avollmaier/ReShuffled/KiCad/Version 0.8/SVGs & PNGs/Atmega324P-Diplomarbeit-Perl.png

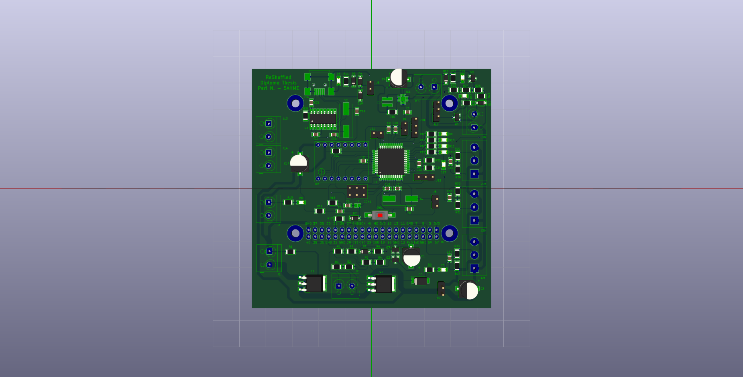
KiCad/Version 0.8/SVGs & PNGs/Atmega324P-Diplomarbeit-Perl.png
