avollmaier/ReShuffled/README.md

<hr>
<hr>
<h1 id="protokoll-nr.-03--">Diplomarbeit  </h1> 
<table> 
<thead> 
<tr>
<th>Diplomant</th>
<th>Aufgabenbereich</th>
<th>Betreuer</th>
</tr>
</thead>
<tbody>
<tr>
<td>Vollmaier Alois</td>
<td>Software</td>
<td><a href="https://github.com/ManfredSteiner">Manfred Steiner</a></td>
</tr>
<tr>
<td>Perl Nicolas</td>
<td>Elektronik</td>
<td><a href="https://github.com/ManfredSteiner">Manfred Steiner</a></td>
</tr>
<tr>
<td>Hörmann Stefan</td>
<td>Mechanik</td>
<td>Gerhard Pretterhofer</td>
</tr>
</tbody>
</table><hr>
<h3 id="themen-übersicht">Themen-Übersicht</h3>
<ul>
<li><strong>[1]</strong> - Konzept
<ul>
<li>[1.1] -</li>
</ul>
</li>
<li><strong>[2]</strong>  - <em>Meilensteinplanung</em>
<ul>
<li>[2.1] -</li>
</ul>
</li>
<li><strong>[3]</strong>  - Links und Sonstiges</li>
</ul>
<hr>
