avollmaier/ReShuffled/Blockdiagramms/Hardware V1.png

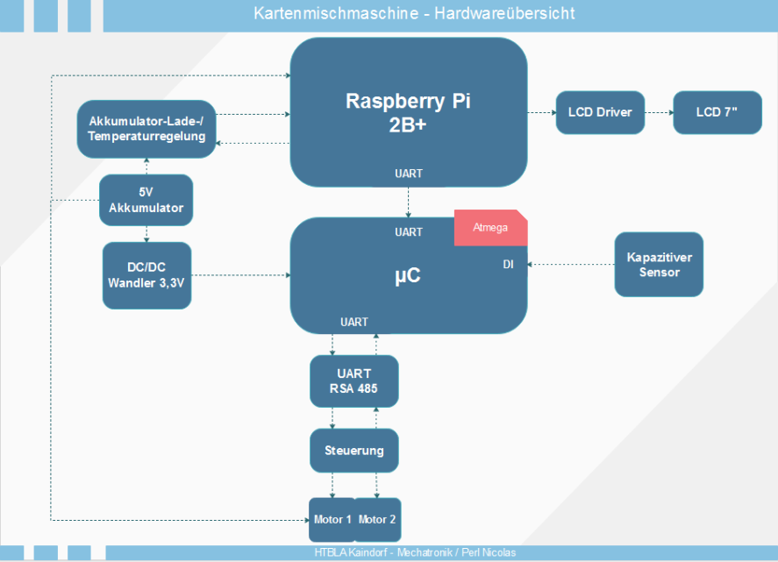
Blockdiagramms/Hardware V1.png
