avollmaier/ReShuffled/(list of files, drawings)

Other design files:
KiCad/Version 0.8/Backups/Atmega324P-Diplomarbeit-Perl-2-11-2019.dsn
KiCad/Version 0.8/Backups/Atmega324P-Diplomarbeit-Perl-16-12-19.dsn
KiCad/Version 0.8/Backups/Atmega324P-Diplomarbeit-Perl-18-09-2019.dsn
KiCad/Version 0.8/Backups/Atmega324P-Diplomarbeit-Perl-18-11-19.dsn
KiCad/Version 0.8/Backups/Atmega324P-Diplomarbeit-Perl-25-11-19.dsn
KiCad/Version 0.8/Backups/Atmega324P-Diplomarbeit-Perl-25-11-2019.dsn
KiCad/Version 0.8/Backups/Atmega324P-Diplomarbeit-Perl-26-11-19.dsn
KiCad/Version 0.8/Backups/Atmega324P-Diplomarbeit-Perl-26-11-2019.dsn
KiCad/Version 0.8/Backups/Atmega324P-Diplomarbeit-Perl-29-11-19.dsn
KiCad/Version 0.8/Backups/Atmega324P-Diplomarbeit-Perl-300819.dsn
KiCad/Version 0.8/Backups/Atmega324P-Diplomarbeit-Perl-1112019.dsn
KiCad/Version 0.8/Backups/Atmega324P-Diplomarbeit-Perl-11012019.dsn
KiCad/Version 0.8/Backups/Atmega324P-Diplomarbeit-Perl-test.dsn
KiCad/Version 0.8/Backups/test123.dsn
