avollmaier/ReShuffled/KiCad/Version 0.8/Atmega324P-Diplomarbeit-Perl.kicad_pcb

## KiCad design KiCad/Version 0.8/Atmega324P-Diplomarbeit-Perl.kicad_pcb (2020-02-07)

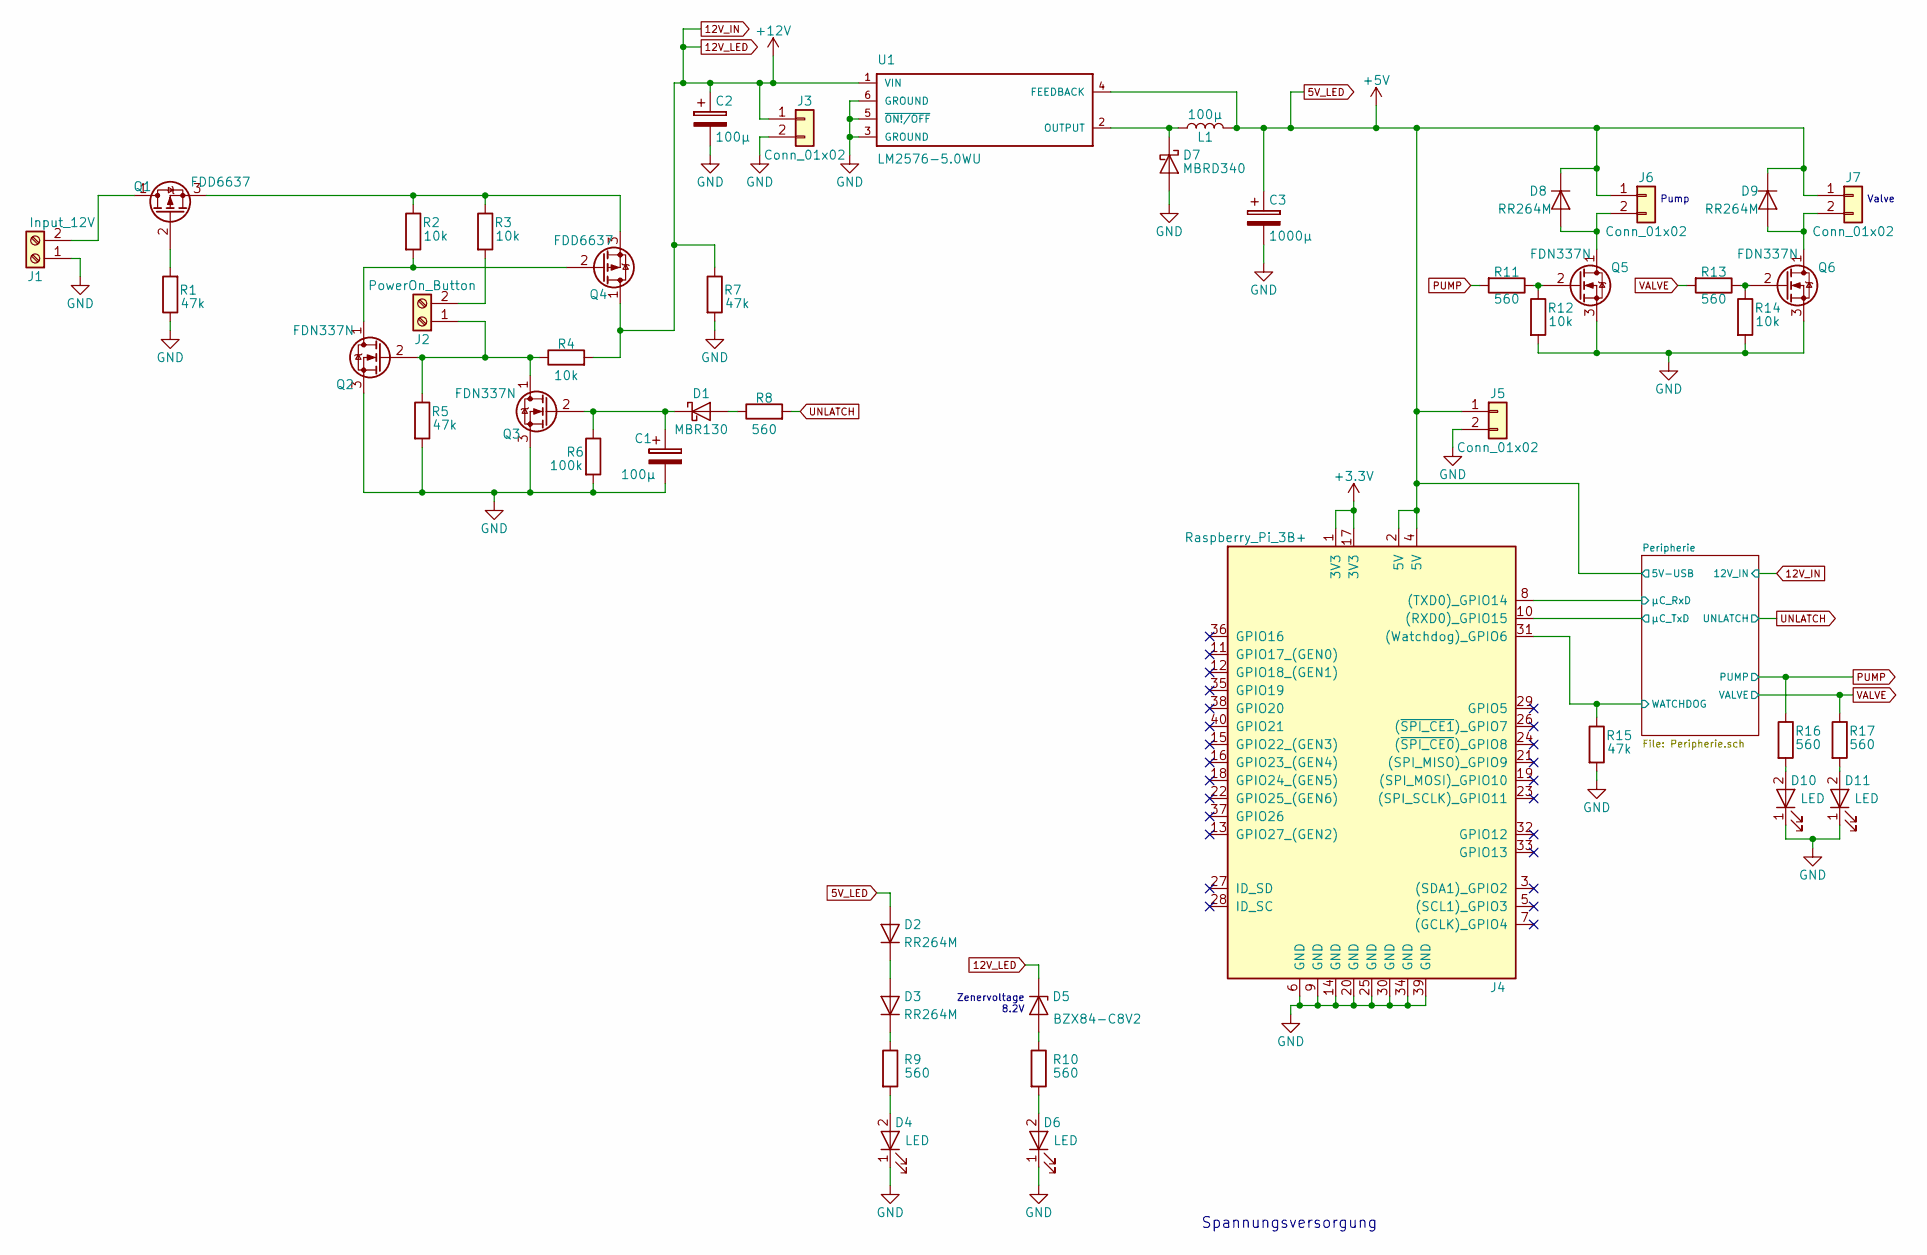
[picture p26: schematic Atmega324P-Diplomarbeit-Perl.sch]

Parts:
C1, C2: 100µ; CP_Elec_8x6.7
C3: 1000µ; CP_Elec_8x10
D1: MBR130; D_SOD-123
D2, D3, D8, D9: RR264M; D_SOD-123
D4, D6, D10, D11: LED; LED_0805
D5: BZX84-C8V2; D_SOT-23_ANK
D7: MBRD340; TO-252-2_Rectifier
J1: Input_12V; Terminalblock-2x-5mm
J2: PowerOn_Button; Terminalblock-2x-5mm
J3, J5, J6, J7: Conn_01x02; Pin_Header_Straight_2x01_Pitch2.54mm
J4: Raspberry_Pi_3B+; Pin_Header_Straight_2x20_Pitch2.54mm
L1: 100µ; L_12x12mm_h6mm
Q1, Q4: FDD6637; TO-252-2_Rectifier
Q2, Q3, Q5, Q6: FDN337N; SOT-23
R1, R5, R7, R15: 47k; R_0805_HandSoldering
R2, R3, R4, R12, R14: 10k; R_0805_HandSoldering
R6: 100k; R_0805_HandSoldering
R8, R9, R10, R11, R13, R16, R17: 560; R_0805_HandSoldering
U1: LM2576-5.0WU; DPAK6P170_1524X459L254X81N

Connections:
5V_LED: C3.1, D2.2 (A), D8.1 (K), D9.1 (K), J4.2 (5V), J4.4 (5V), J5.1, J6.1, J7.1, L1.2, U1.4 (FEEDBACK); also elsewhere on the board
+3V3: J4.1 (3V3), J4.17 (3V3); also elsewhere on the board
/Peripherie/WATCHDOG: J4.31 ((Watchdog)_GPIO6), R15.1; also elsewhere on the board
/Peripherie/µC_RxD: J4.8 ((TXD0)_GPIO14); also elsewhere on the board
/Peripherie/µC_TxD: J4.10 ((RXD0)_GPIO15); also elsewhere on the board
GND: C1.2, C2.2, C3.2, D4.1 (K), D6.1 (K), D7.1 (A), D10.1 (K), D11.1 (K), J1.1, J3.2, J4.6 (GND), J4.9 (GND), J4.14 (GND), J4.20 (GND), J4.25 (GND), J4.30 (GND), J4.34 (GND), J4.39 (GND), J5.2, Q2.3 (S), Q3.3 (S), Q5.3 (S), Q6.3 (S), R1.1, R5.2, R6.2, R7.2, R12.2, R14.2, R15.2, U1.3 (GROUND), U1.5 (~ON!/OFF~), U1.6 (GROUND); also elsewhere on the board
unnamed: C1.1, D1.2 (K), Q3.2 (G), R6.1
unnamed: D1.1 (A), R8.1
unnamed: D2.1 (K), D3.2 (A)
unnamed: D3.1 (K), R9.1
unnamed: D4.2 (A), R9.2
unnamed: D5.2 (A), R10.1
unnamed: D6.2 (A), R10.2
unnamed: D7.2 (K), L1.1, U1.2 (OUTPUT)
unnamed: D8.2 (A), J6.2, Q5.1 (D)
unnamed: D9.2 (A), J7.2, Q6.1 (D)
unnamed: D10.2 (A), R16.2
unnamed: D11.2 (A), R17.2
unnamed: J2.1, Q2.2 (G), Q3.1 (D), R4.1, R5.1
unnamed: J2.2, R3.2
unnamed: Q1.2 (G), R1.2
unnamed: Q5.2 (G), R11.1, R12.1
unnamed: Q6.2 (G), R13.1, R14.1
PUMP: R11.2, R16.1; also elsewhere on the board
UNLATCH: R8.2; also elsewhere on the board
VALVE: R13.2, R17.1; also elsewhere on the board

Notes on the sheet:
Spannungsversorgung
Zenervoltage 8.2V
Pump
Valve

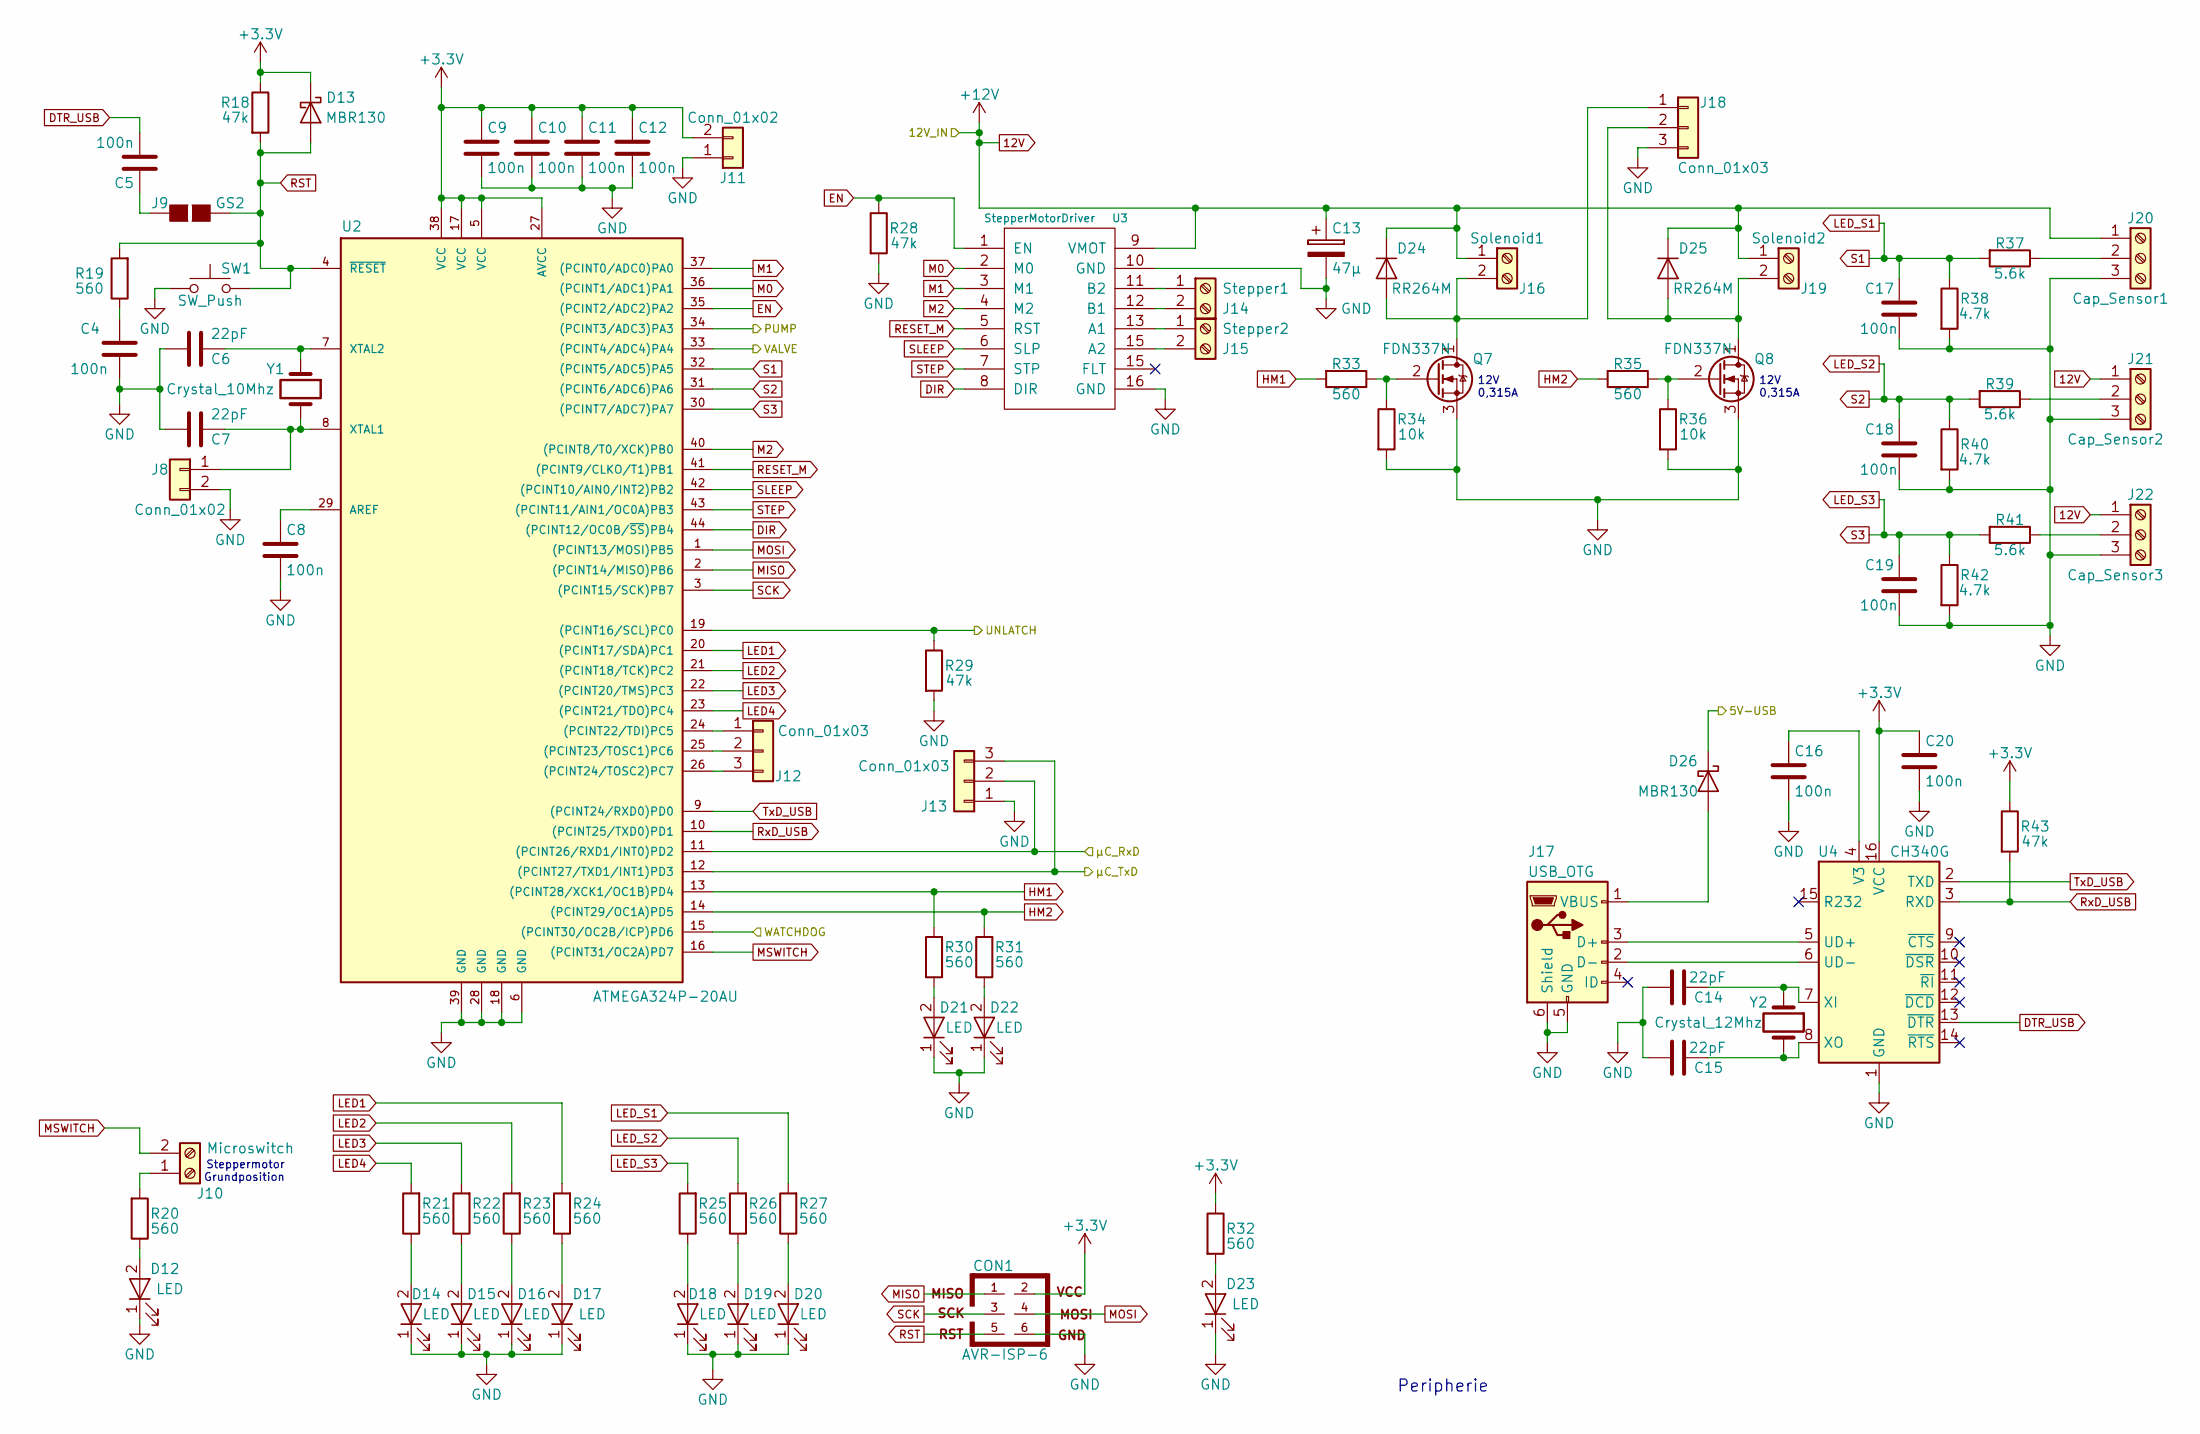
[picture p27: schematic Peripherie.sch]

Parts:
C4, C5, C8, C9, C10, C11, C12, C16, C17, C18, C19, C20: 100n; C_0805_HandSoldering
C6, C7, C14, C15: 22pF; C_1206_HandSoldering
C13: 47µ; CP_Elec_6.3x5.8
CON1: AVR-ISP-6; Pin_Header_Straight_2x03_Pitch2.54mm
D12, D14, D15, D16, D17, D18, D19, D20, D21, D22, D23: LED; LED_0805
D13, D26: MBR130; D_SOD-123
D24, D25: RR264M; D_SOD-123
J8, J11: Conn_01x02; Pin_Header_Straight_1x02_Pitch2.54mm
J9: GS2
J10: Microswitch; Terminalblock-2x-5mm
J12, J13, J18: Conn_01x03; Pin_Header_Straight_1x03_Pitch2.54mm
J14: Stepper1; Terminalblock-2x-5mm
J15: Stepper2; Terminalblock-2x-5mm
J16: Solenoid1; Terminalblock-2x-5mm
J17: USB_OTG; USB_Mini-B
J19: Solenoid2; Terminalblock-2x-5mm
J20: Cap_Sensor1; Terminalblock-3x-5mm
J21: Cap_Sensor2; Terminalblock-3x-5mm
J22: Cap_Sensor3; Terminalblock-3x-5mm
Q7, Q8: FDN337N; SOT-23
R18, R28, R29, R43: 47k; R_0805_HandSoldering
R19, R20, R21, R22, R23, R24, R25, R26, R27, R30, R31, R32, R33, R35: 560; R_0805_HandSoldering
R34, R36: 10k; R_0805_HandSoldering
R37, R39, R41: 5.6k; R_0805_HandSoldering
R38, R40, R42: 4.7k; R_0805_HandSoldering
SW1: SW_Push; SW_SPST_FSMSM
U2: ATMEGA324P-20AU; TQFP-44_10x10mm_Pitch0.8mm_Handsolded
U3: StepperMotorDriver; StepperSocket
U4: CH340G; SOIC-16_3.9x9.9mm_Pitch1.27mm_HANDSOLDERED
Y1: Crystal_10Mhz; Crystal_SMD_HC49-SD
Y2: Crystal_12Mhz; Crystal_SMD_HC49-SD

Connections:
5V_LED: D26.2 (K); also elsewhere on the board
+3V3: C9.1, C10.1, C11.1, C12.1, C20.1, CON1.2, D13.2 (K), J11.2, R18.1, R32.1, R43.1, U2.5 (VCC), U2.17 (VCC), U2.27 (AVCC), U2.38 (VCC), U4.16 (VCC); also elsewhere on the board
/Peripherie/WATCHDOG: U2.15 ((PCINT30/OC2B/ICP)PD6); also elsewhere on the board
/Peripherie/µC_RxD: J13.2, U2.11 ((PCINT26/RXD1/INT0)PD2); also elsewhere on the board
/Peripherie/µC_TxD: J13.3, U2.12 ((PCINT27/TXD1/INT1)PD3); also elsewhere on the board
DIR: U2.44 ((PCINT12/OC0B/~SS~)PB4), U3.8 (DIR)
DTR_USB: C5.2, U4.13 (~DTR)
EN: R28.1, U2.35 ((PCINT2/ADC2)PA2), U3.1 (EN)
GND: C4.2, C6.2, C7.2, C8.2, C9.2, C10.2, C11.2, C12.2, C13.2, C14.2, C15.2, C16.2, C17.2, C18.2, C19.2, C20.2, CON1.6, D12.1 (K), D14.1 (K), D15.1 (K), D16.1 (K), D17.1 (K), D18.1 (K), D19.1 (K), D20.1 (K), D21.1 (K), D22.1 (K), D23.1 (K), J8.2, J11.1, J13.1, J17.5 (GND), J17.6 (Shield), J18.3, J20.3, J21.3, J22.3, Q7.3 (S), Q8.3 (S), R28.2, R29.2, R34.2, R36.2, R38.2, R40.2, R42.2, SW1.1, U2.6 (GND), U2.18 (GND), U2.28 (GND), U2.39 (GND), U3.10 (GND), U3.16 (GND), U4.1 (GND); also elsewhere on the board
HM1: R30.2, R33.2, U2.13 ((PCINT28/XCK1/OC1B)PD4)
HM2: R31.2, R35.2, U2.14 ((PCINT29/OC1A)PD5)
LED1: R24.2, U2.20 ((PCINT17/SDA)PC1)
LED2: R23.2, U2.21 ((PCINT18/TCK)PC2)
LED3: R22.2, U2.22 ((PCINT20/TMS)PC3)
LED4: R21.2, U2.23 ((PCINT21/TDO)PC4)
LED_S1: C17.1, R27.2, R37.2, R38.1, U2.32 ((PCINT5/ADC5)PA5)
LED_S2: C18.1, R26.2, R39.2, R40.1, U2.31 ((PCINT6/ADC6)PA6)
LED_S3: C19.1, R25.2, R41.2, R42.1, U2.30 ((PCINT7/ADC7)PA7)
M0: U2.36 ((PCINT1/ADC1)PA1), U3.2 (M0)
M1: U2.37 ((PCINT0/ADC0)PA0), U3.3 (M1)
M2: U2.40 ((PCINT8/T0/XCK)PB0), U3.4 (M2)
MISO: CON1.1, U2.2 ((PCINT14/MISO)PB6)
MOSI: CON1.4, U2.1 ((PCINT13/MOSI)PB5)
MSWITCH: J10.2, U2.16 ((PCINT31/OC2A)PD7)
unnamed: C4.1, R19.1
unnamed: C5.1, J9.1 (G1)
unnamed: C6.1, U2.7 (XTAL2), Y1.1
unnamed: C7.1, J8.1, U2.8 (XTAL1), Y1.2
unnamed: C8.1, U2.29 (AREF)
unnamed: C14.1, U4.7 (XI), Y2.1
unnamed: C15.1, U4.8 (XO), Y2.2
unnamed: C16.1, U4.4 (V3)
unnamed: D12.2 (A), R20.1
unnamed: D14.2 (A), R21.1
unnamed: D15.2 (A), R22.1
unnamed: D16.2 (A), R23.1
unnamed: D17.2 (A), R24.1
unnamed: D18.2 (A), R25.1
unnamed: D19.2 (A), R26.1
unnamed: D20.2 (A), R27.1
unnamed: D21.2 (A), R30.1
unnamed: D22.2 (A), R31.1
unnamed: D23.2 (A), R32.2
unnamed: D24.2 (A), J16.2, J18.1, Q7.1 (D)
unnamed: D25.2 (A), J18.2, J19.2, Q8.1 (D)
unnamed: D26.1 (A), J17.1 (VBUS)
unnamed: J10.1, R20.2
unnamed: J12.1, U2.24 ((PCINT22/TDI)PC5)
unnamed: J12.2, U2.25 ((PCINT23/TOSC1)PC6)
unnamed: J12.3, U2.26 ((PCINT24/TOSC2)PC7)
unnamed: J14.1, U3.11 (B2)
unnamed: J14.2, U3.12 (B1)
unnamed: J15.1, U3.13 (A1)
unnamed: J17.2 (D-), U4.6 (UD-)
unnamed: J17.3 (D+), U4.5 (UD+)
unnamed: J20.2, R37.1
unnamed: J21.2, R39.1
unnamed: J22.2, R41.1
unnamed: Q7.2 (G), R33.1, R34.1
unnamed: Q8.2 (G), R35.1, R36.1
PUMP: U2.34 ((PCINT3/ADC3)PA3); also elsewhere on the board
RESET_M: U2.41 ((PCINT9/CLKO/T1)PB1), U3.5 (RST)
RST: CON1.5, D13.1 (A), J9.2 (G2), R18.2, R19.2, SW1.2, U2.4 (~RESET)
RxD_USB: R43.2, U2.10 ((PCINT25/TXD0)PD1), U4.3 (RXD)
SCK: CON1.3, U2.3 ((PCINT15/SCK)PB7)
SLEEP: U2.42 ((PCINT10/AIN0/INT2)PB2), U3.6 (SLP)
STEP: U2.43 ((PCINT11/AIN1/OC0A)PB3), U3.7 (STP)
TxD_USB: U2.9 ((PCINT24/RXD0)PD0), U4.2 (TXD)
UNLATCH: R29.1, U2.19 ((PCINT16/SCL)PC0); also elsewhere on the board
VALVE: U2.33 ((PCINT4/ADC4)PA4); also elsewhere on the board

Notes on the sheet:
Peripherie
12V 0,315A
Steppermotor Grundposition

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
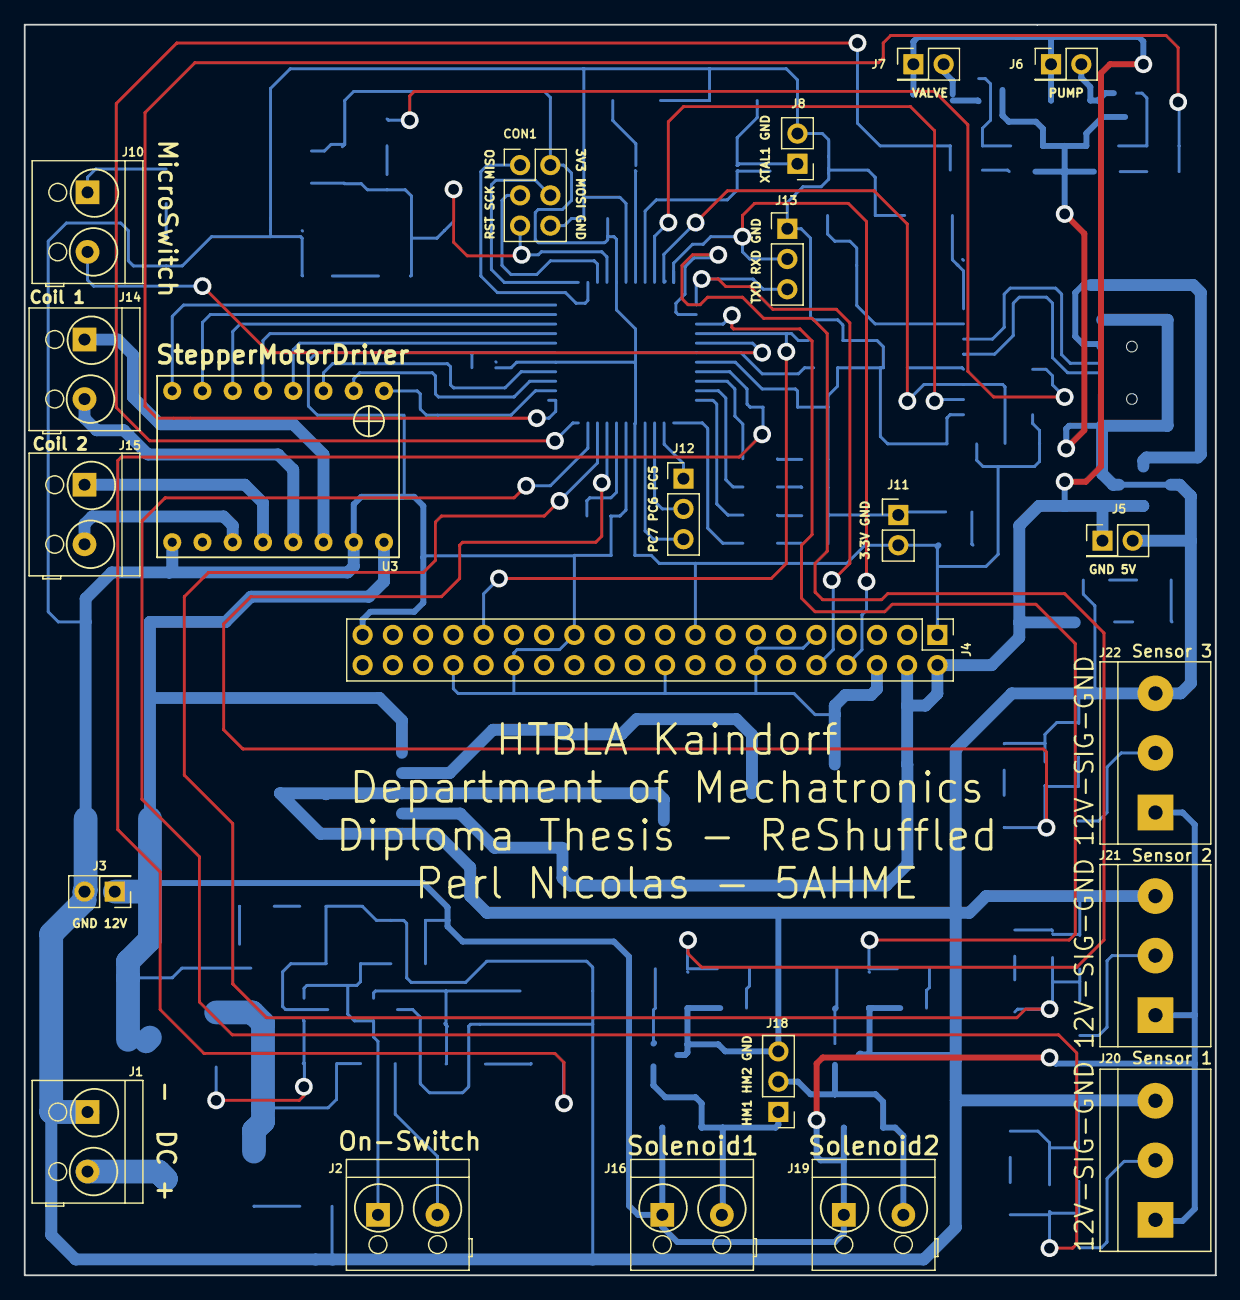
[picture p28: board Atmega324P-Diplomarbeit-Perl.kicad_pcb from above]

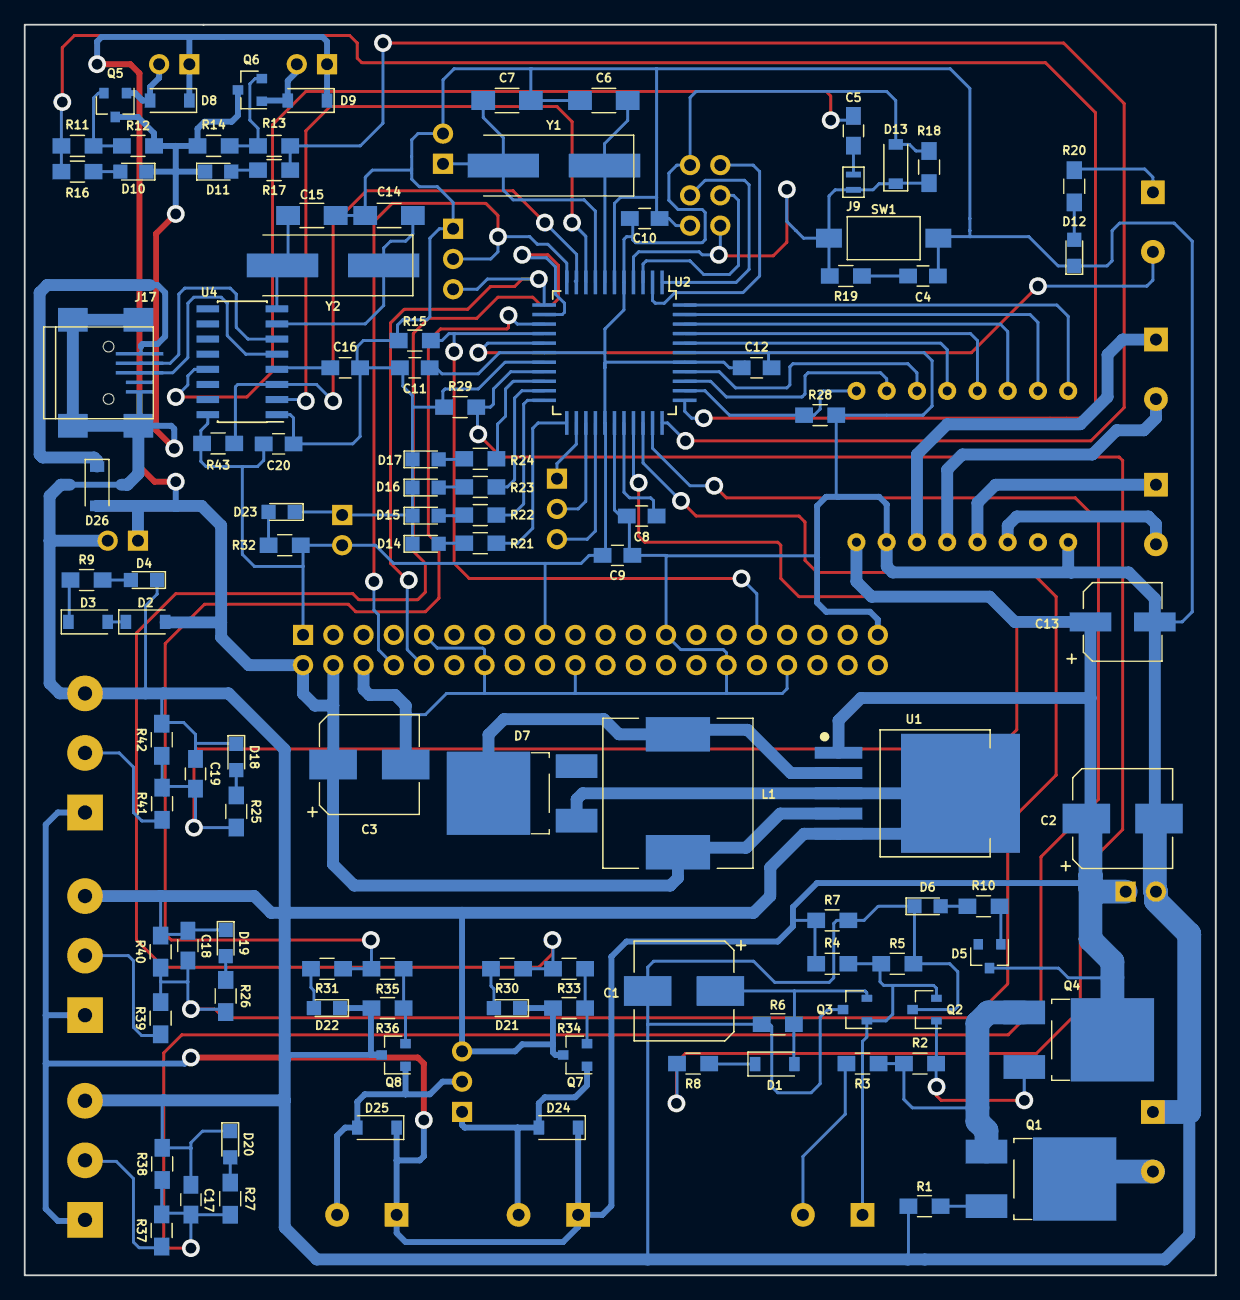
[picture p29: board Atmega324P-Diplomarbeit-Perl.kicad_pcb from below]

Board: 2 copper layers, 100.0 x 105.0 mm, 128 parts (106 on the bottom side), 91 nets.
