avollmaier/ReShuffled/(commit log)

2019-05-06 Commit Test
    [Diplomarbeit_Kartenanalyse (1).xlsm, Meilensteine und Pflichtenheft.xlsx]
2019-05-06 Added all repositorys
    [Diplomarbeit_Kartenanalyse (1).xlsm, Meilensteine und Pflichtenheft.xlsx]
2019-05-29 script commit | RSmaster
    [htl-a4.dxf]
2019-12-13 KiCad Project addes
    [Atmega324P-Diplomarbeit-Perl-11012019.dsn, Atmega324P-Diplomarbeit-Perl-1112019.dsn, Atmega324P-Diplomarbeit-Perl-18-09-2019.dsn, Atmega324P-Diplomarbeit-Perl-18-11-19.dsn, Atmega324P-Diplomarbeit-Perl-2-11-2019.dsn, Atmega324P-Diplomarbeit-Perl-25-11-19.dsn, Atmega324P-Diplomarbeit-Perl-25-11-2019.dsn, Atmega324P-Diplomarbeit-Perl-26-11-19.dsn]
2019-12-13 kiCad files updated
2019-12-19 KiCad Prj updated
    [Atmega324P-Diplomarbeit-Perl-11012019.dsn, Atmega324P-Diplomarbeit-Perl-1112019.dsn, Atmega324P-Diplomarbeit-Perl-16-12-19.dsn, Atmega324P-Diplomarbeit-Perl-18-09-2019.dsn, Atmega324P-Diplomarbeit-Perl-18-11-19.dsn, Atmega324P-Diplomarbeit-Perl-2-11-2019.dsn, Atmega324P-Diplomarbeit-Perl-25-11-19.dsn, Atmega324P-Diplomarbeit-Perl-25-11-2019.dsn]
2020-01-08 KiCad Version 0.3 added
    [Atmega324P-Diplomarbeit-Perl-08-01-2020.csv, Atmega324P-Diplomarbeit-Perl-11012019.dsn, Atmega324P-Diplomarbeit-Perl-1112019.dsn, Atmega324P-Diplomarbeit-Perl-16-12-19.dsn, Atmega324P-Diplomarbeit-Perl-18-09-2019.dsn, Atmega324P-Diplomarbeit-Perl-18-11-19.dsn, Atmega324P-Diplomarbeit-Perl-2-11-2019.dsn, Atmega324P-Diplomarbeit-Perl-25-11-19.dsn]
2020-01-08 KiCad Version 0.31 added
    [Atmega324P-Diplomarbeit-Perl-08-01-2020.csv, Atmega324P-Diplomarbeit-Perl-11012019.dsn, Atmega324P-Diplomarbeit-Perl-1112019.dsn, Atmega324P-Diplomarbeit-Perl-16-12-19.dsn, Atmega324P-Diplomarbeit-Perl-18-09-2019.dsn, Atmega324P-Diplomarbeit-Perl-18-11-19.dsn, Atmega324P-Diplomarbeit-Perl-2-11-2019.dsn, Atmega324P-Diplomarbeit-Perl-25-11-19.dsn]
2020-01-13 KiCad Version 0.4 added
    [Atmega324P-Diplomarbeit-Perl-08-01-2020.csv, Atmega324P-Diplomarbeit-Perl-11012019.dsn, Atmega324P-Diplomarbeit-Perl-1112019.dsn, Atmega324P-Diplomarbeit-Perl-16-12-19.dsn, Atmega324P-Diplomarbeit-Perl-18-09-2019.dsn, Atmega324P-Diplomarbeit-Perl-18-11-19.dsn, Atmega324P-Diplomarbeit-Perl-2-11-2019.dsn, Atmega324P-Diplomarbeit-Perl-25-11-19.dsn]
2020-01-14 KiCad Version 0.5 added
    [Atmega324P-Diplomarbeit-Perl-08-01-2020.csv, Atmega324P-Diplomarbeit-Perl-11012019.dsn, Atmega324P-Diplomarbeit-Perl-1112019.dsn, Atmega324P-Diplomarbeit-Perl-16-12-19.dsn, Atmega324P-Diplomarbeit-Perl-18-09-2019.dsn, Atmega324P-Diplomarbeit-Perl-18-11-19.dsn, Atmega324P-Diplomarbeit-Perl-2-11-2019.dsn, Atmega324P-Diplomarbeit-Perl-25-11-19.dsn]
2020-01-14 created KiCad Version 0.51
    [Atmega324P-Diplomarbeit-Perl-08-01-2020.csv, Atmega324P-Diplomarbeit-Perl-11012019.dsn, Atmega324P-Diplomarbeit-Perl-1112019.dsn, Atmega324P-Diplomarbeit-Perl-16-12-19.dsn, Atmega324P-Diplomarbeit-Perl-18-09-2019.dsn, Atmega324P-Diplomarbeit-Perl-18-11-19.dsn, Atmega324P-Diplomarbeit-Perl-2-11-2019.dsn, Atmega324P-Diplomarbeit-Perl-25-11-19.dsn]
2020-01-14 KiCad Version 0.6 added
    [Atmega324P-Diplomarbeit-Perl-08-01-2020.csv, Atmega324P-Diplomarbeit-Perl-11012019.dsn, Atmega324P-Diplomarbeit-Perl-1112019.dsn, Atmega324P-Diplomarbeit-Perl-16-12-19.dsn, Atmega324P-Diplomarbeit-Perl-18-09-2019.dsn, Atmega324P-Diplomarbeit-Perl-18-11-19.dsn, Atmega324P-Diplomarbeit-Perl-2-11-2019.dsn, Atmega324P-Diplomarbeit-Perl-25-11-19.dsn]
2020-02-05 KiCad Version 0.7 added
    [Atmega324P-Diplomarbeit-Perl-11012019.dsn, Atmega324P-Diplomarbeit-Perl-1112019.dsn, Atmega324P-Diplomarbeit-Perl-16-12-19.dsn, Atmega324P-Diplomarbeit-Perl-18-09-2019.dsn, Atmega324P-Diplomarbeit-Perl-18-11-19.dsn, Atmega324P-Diplomarbeit-Perl-2-11-2019.dsn, Atmega324P-Diplomarbeit-Perl-25-11-19.dsn, Atmega324P-Diplomarbeit-Perl-25-11-2019.dsn]
2020-02-07 added version 0.8
    [Atmega324P-Diplomarbeit-Perl-11012019.dsn, Atmega324P-Diplomarbeit-Perl-1112019.dsn, Atmega324P-Diplomarbeit-Perl-16-12-19.dsn, Atmega324P-Diplomarbeit-Perl-18-09-2019.dsn, Atmega324P-Diplomarbeit-Perl-18-11-19.dsn, Atmega324P-Diplomarbeit-Perl-2-11-2019.dsn, Atmega324P-Diplomarbeit-Perl-25-11-19.dsn, Atmega324P-Diplomarbeit-Perl-25-11-2019.dsn]
